tkrahn/pecanpico4/README.md

The fourth version of the Pecan Pico board and the associated software.
Some more info is on my blog: 
http://kt5tk.wordpress.com/2013/07/24/pecan-pico-4-serial-number-1-built-working
