tkrahn/pecanpico4/eagle/PecanPico4.brd

## EAGLE design eagle/PecanPico4.brd (2013-10-09)

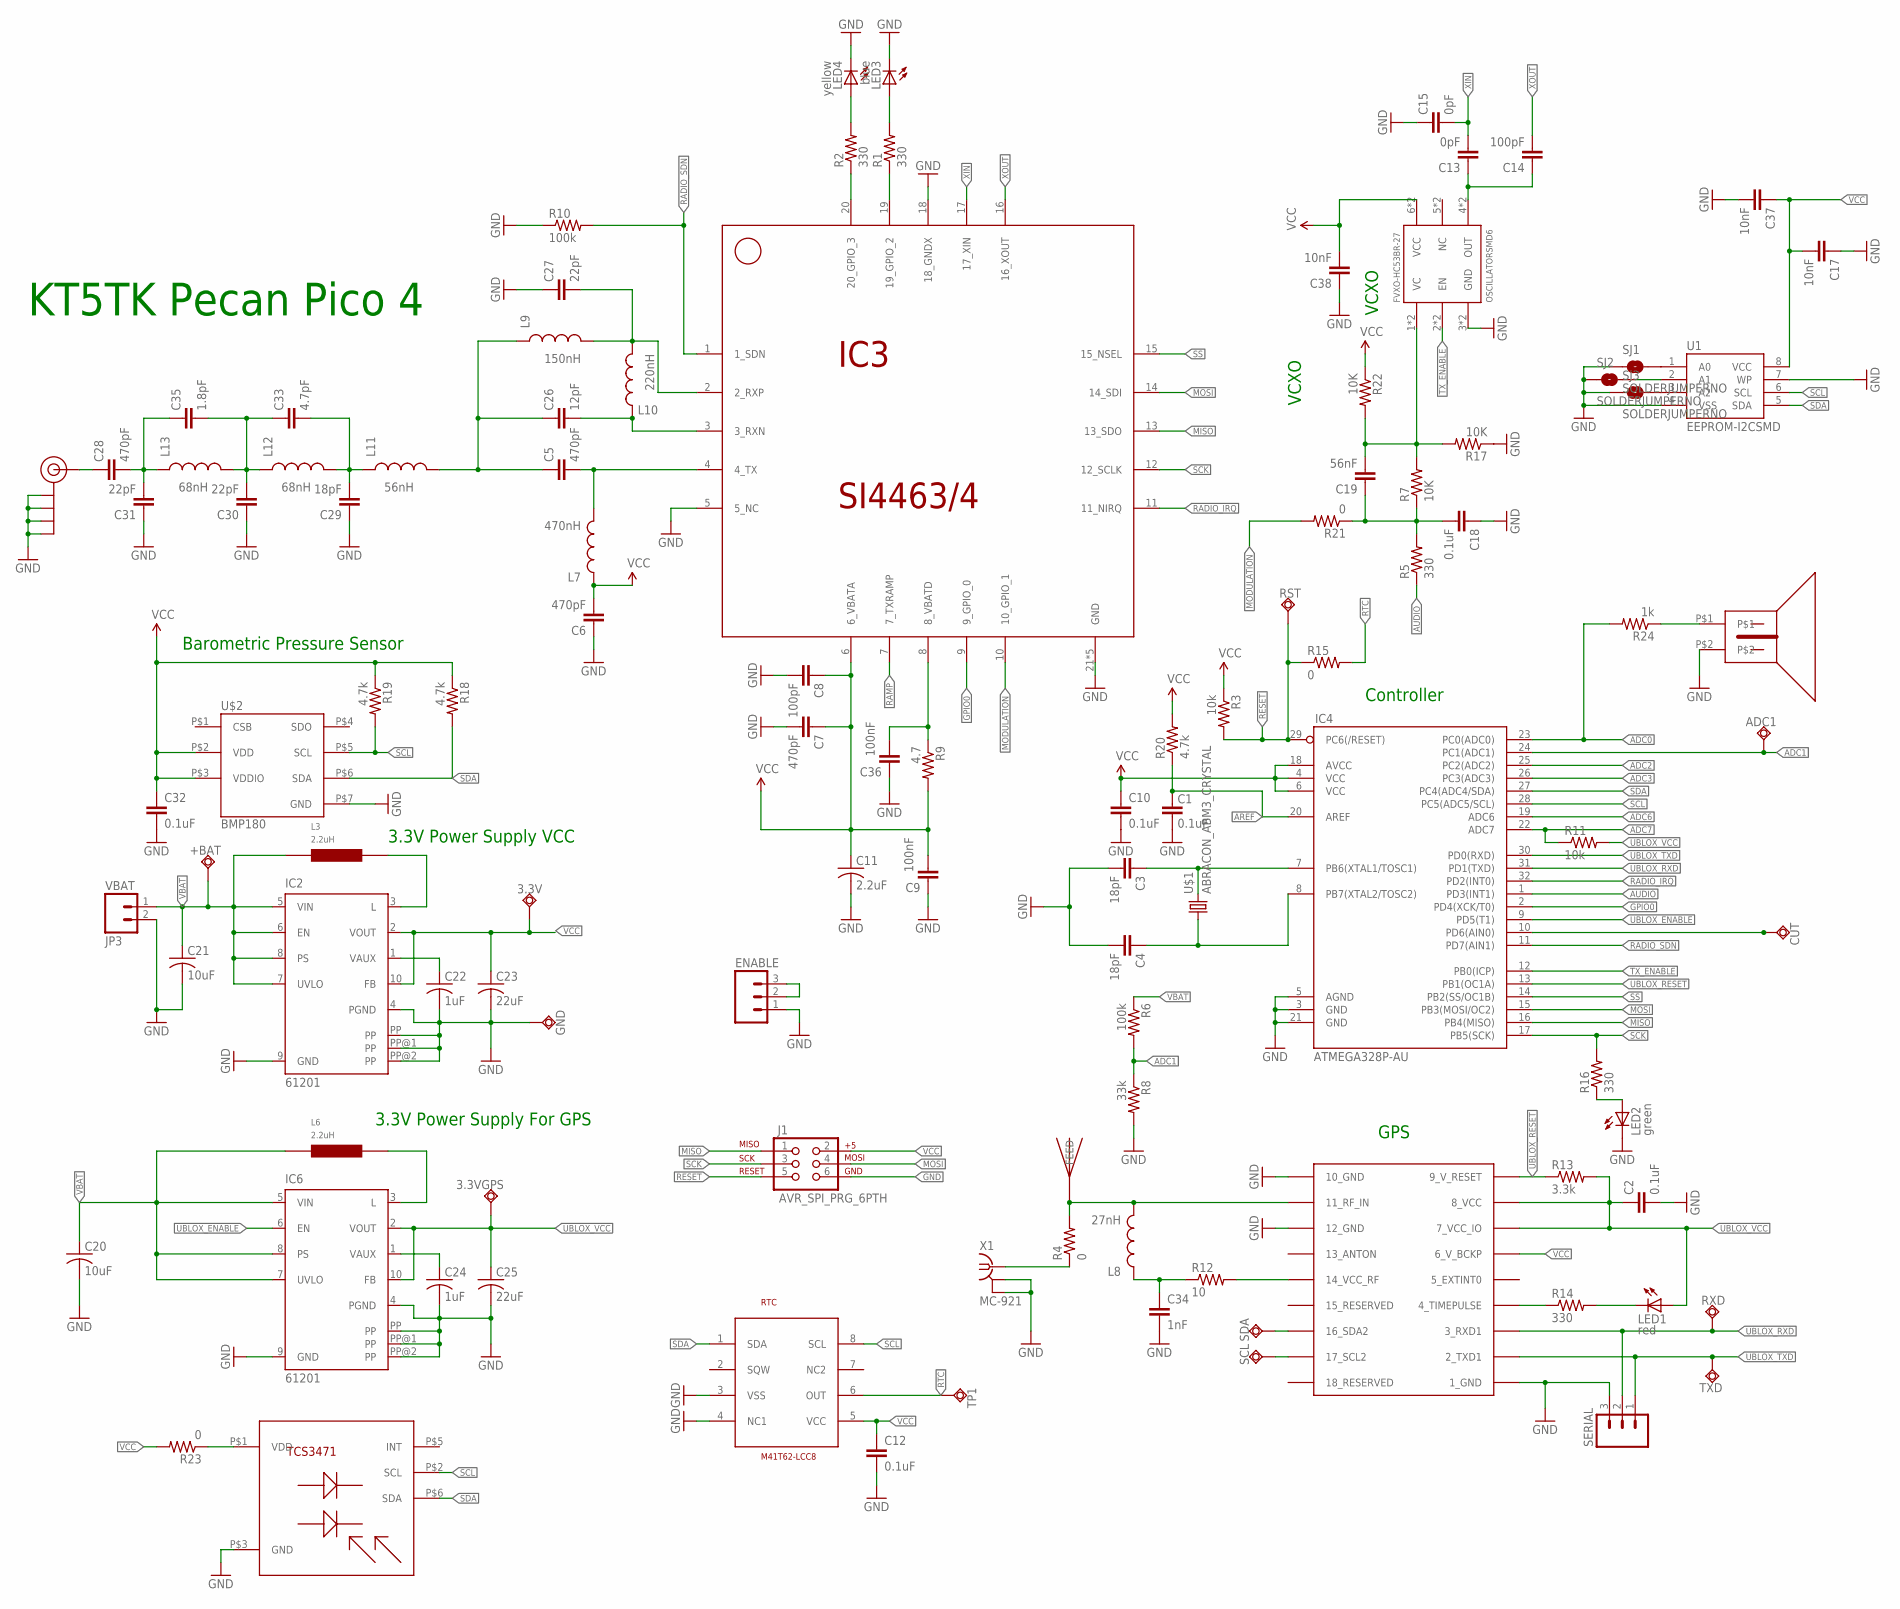
[picture p1: schematic PecanPico4.sch]

Parts:
3.3V, 3.3VGPS: TPSQTP06R; TP06R
+BAT: TPSQTP06R; TP06R
ADC1: TPSQTP06R; TP06R
C1, C2, C10, C12, C18, C32: 0.1uF; 0402-CAP
C3, C4, C29: 18pF; 0402-CAP
C5, C6, C7, C28: 470pF; 0402-CAP
C8, C14: 100pF; 0402-CAP
C9, C36: 100nF; 0402-CAP
C11: 2.2uF; C1206
C13, C15: 0pF; 0402-CAP
C17, C37, C38: 10nF; 0402-CAP
C19: 56nF; 0402-CAP
C20, C21: 10uF; C1206
C22, C24: 1uF; C1206
C23, C25: 22uF; C1206
C26: 12pF; 0402-CAP
C27, C30, C31: 22pF; 0402-CAP
C33: 4.7pF; 0402-CAP
C34: 1nF; 0402-CAP
C35: 1.8pF; 0402-CAP
CUT: TPSQTP06R; TP06R
ENABLE: M03PTH; 1X03
FVXO-HC53BR-27: OSCILLATORSMD6; CRYSTAL-SMD-7.5X5.2-6PIN
GND: TPSQTP06R; TP06R
IC2, IC6: 61201; S-PDSO-N10
IC3: SI4463/4; QFN-20
IC4: ATMEGA328P-AU; TQFP32-08
IC5: UBLOX_MAX-6
J1: AVR_SPI_PRG_6PTH; 2X3
J$2: SMA_EDGE; SMA-EDGE
JP3: VBAT; 1X02
L3, L6: 2.2uH; LPS3015
L7: 470nH; 0603
L8: 27nH; 0603
L9: 150nH; 0603
L10: 220nH; 0603
L11: 56nH; 0603
L12, L13: 68nH; 0603
LED1: red; LED-0603
LED2: green; LED-0603
LED3: blue; LED-0603
LED4: yellow; LED-0603
R1, R2, R5, R14, R16: 330; 0402-RES
R3, R11: 10k; 0402-RES
R4, R15, R21, R23: 0; 0402-RES
R6, R10: 100k; 0402-RES
R7, R17, R22: 10K; 0402-RES
R8: 33k; 0402-RES
R9: 4.7; 0402-RES
R12: 10; 0402-RES
R13: 3.3k; 0402-RES
R18, R19, R20: 4.7k; 0402-RES
R24: 1k; 0402-RES
RST: TPSQTP06R; TP06R
RTC: M41T62-LCC8; LCC-8
RXD: TPSQTP06R; TP06R
SCL: TPSQTP06R; TP06R
SDA: TPSQTP06R; TP06R
SERIAL: M03PTH; 1X03
SJ1, SJ2, SJ3: SOLDERJUMPERNO; SJ_2S-NO
SPKR: PKLCS1212E
TCS3471: TCS4371FN; TCS3471FN
TP1: TPSQTP06R; TP06R
TXD: TPSQTP06R; TP06R
U1: EEPROM-I2CSMD; SO08
U$1: ABRACON_ABM3_CRYSTAL
U$2: BMP180; LGA-7
U$3: JTI_ANTENNA-1575AT43A40
X1: MC-921

Connections:
ADC0: IC4.23 (PC0(ADC0)), R24.2
ADC1: ADC1.TP, IC4.24 (PC1(ADC1)), R6.2, R8.1
ADC2: IC4.25 (PC2(ADC2))
ADC3: IC4.26 (PC3(ADC3))
ADC6: IC4.19 (ADC6)
ADC7: IC4.22 (ADC7), R11.1
AREF: C1.2, IC4.20 (AREF), R20.1
AUDIO: IC4.1 (PD3(INT1)), R5.1
CUT: CUT.TP, IC4.10 (PD6(AIN0))
GND: C1.1, C2.2, C3.2, C4.2, C6.1, C7.2, C8.2, C9.1, C10.2, C11.2, C12.2, C15.1, C17.1, C18.1, C20.2, C21.2, C22.2, C23.2, C24.2, C25.2, C27.1, C29.1, C30.1, C31.1, C32.2, C34.2, C36.1, C37.2, C38.1, ENABLE.1, FVXO-HC53BR-27.3 (GND), FVXO-HC53BR-27.3INNER (GND), GND.TP, IC2.4 (PGND), IC2.9 (GND), IC2.PP, IC2.PP@1 (PP), IC2.PP@2 (PP), IC3.5 (5_NC), IC3.18 (18_GNDX), IC3.21 (GND), IC3.22 (GND), IC3.23 (GND), IC3.24 (GND), IC3.25 (GND), IC4.3 (GND), IC4.5 (AGND), IC4.21 (GND), IC5.1_GND, IC5.10_GND, IC5.12_GND, IC6.4 (PGND), IC6.9 (GND), IC6.PP, IC6.PP@1 (PP), IC6.PP@2 (PP), J1.6, J$2.GND@0 (GND), J$2.GND@1 (GND), J$2.GND@2 (GND), J$2.GND@3 (GND), JP3.2, LED2.C, LED3.C, LED4.C, R8.2, R10.1, R17.1, RTC.3 (VSS), RTC.4 (NC1), SERIAL.3, SJ1.1, SJ2.1, SJ3.1, SPKR.P$2, TCS3471.P$3 (GND), U1.4 (VSS), U1.7 (WP), U$2.P$7 (GND), X1.2@1 (GND), X1.2@2 (GND)
GPIO0: IC3.9 (9_GPIO_0), IC4.2 (PD4(XCK/T0))
GPSANT: IC5.11_RF_IN, L8.2, R4.2, U$3.FEED
MISO: IC3.13 (13_SDO), IC4.16 (PB4(MISO)), J1.1
MODULATION: IC3.10 (10_GPIO_1), R21.2
MOSI: IC3.14 (14_SDI), IC4.15 (PB3(MOSI/OC2)), J1.4
unnamed: R23.1, TCS3471.P$1 (VDD)
unnamed: IC5.16_SDA2, SDA.TP
unnamed: IC5.17_SCL2, SCL.TP
unnamed: IC2.3 (L), L3.P$2 (2)
unnamed: IC3.20 (20_GPIO_3), R2.1
unnamed: C18.2, C19.1, R5.2, R7.1, R21.1
unnamed: IC3.19 (19_GPIO_2), R1.1
unnamed: SJ1.2, U1.1 (A0)
unnamed: C3.1, IC4.7 (PB6(XTAL1/TOSC1)), U$1.P$2 (2)
unnamed: C4.1, IC4.8 (PB7(XTAL2/TOSC2)), U$1.P$1 (1)
unnamed: LED4.A, R2.2
unnamed: LED3.A, R1.2
unnamed: C13.1, C14.1, FVXO-HC53BR-27.4 (OUT), FVXO-HC53BR-27.4INNER (OUT)
unnamed: R4.1, X1.1
unnamed: SJ3.2, U1.3 (A2)
unnamed: SJ2.2, U1.2 (A1)
unnamed: R24.1, SPKR.P$1
unnamed: C22.1, IC2.1 (VAUX)
unnamed: IC6.3 (L), L6.P$2 (2)
unnamed: C19.2, FVXO-HC53BR-27.1 (VC), FVXO-HC53BR-27.1INNER (VC), R7.2, R17.2, R22.2
unnamed: C24.1, IC6.1 (VAUX)
unnamed: C5.2, IC3.4 (4_TX), L7.2
unnamed: C28.1, J$2.SIG (SIGNAL)
unnamed: C26.2, IC3.3 (3_RXN), L10.1
unnamed: C27.2, IC3.2 (2_RXP), L9.2, L10.2
unnamed: C5.1, C26.1, L9.1, L11.2
unnamed: C30.2, C33.1, C35.2, L12.1, L13.2
unnamed: ENABLE.2, ENABLE.3
unnamed: IC5.14_VCC_RF, R12.2
unnamed: C34.1, L8.1, R12.1
unnamed: IC5.4_TIMEPULSE, R14.1
unnamed: LED1.C, R14.2
unnamed: C29.2, C33.2, L11.1, L12.2
unnamed: C28.2, C31.2, C35.1, L13.1
unnamed: LED2.A, R16.1
unnamed: C36.2, IC3.8 (8_VBATD), R9.1
RADIO_IRQ: IC3.11 (11_NIRQ), IC4.32 (PD2(INT0))
RADIO_SDN: IC3.1 (1_SDN), IC4.11 (PD7(AIN1)), R10.2
RAMP: IC3.7 (7_TXRAMP)
RESET: IC4.29 (PC6(/RESET)), J1.5, R3.2, R15.1, RST.TP
RTC: R15.2, RTC.6 (OUT), TP1.TP
SCK: IC3.12 (12_SCLK), IC4.17 (PB5(SCK)), J1.3, R16.2
SCL: IC4.28 (PC5(ADC5/SCL)), R19.2, RTC.8 (SCL), TCS3471.P$2 (SCL), U1.6 (SCL), U$2.P$5 (SCL)
SDA: IC4.27 (PC4(ADC4/SDA)), R18.2, RTC.1 (SDA), TCS3471.P$6 (SDA), U1.5 (SDA), U$2.P$6 (SDA)
SS: IC3.15 (15_NSEL), IC4.14 (PB2(SS/OC1B))
TX_ENABLE: FVXO-HC53BR-27.2 (EN), FVXO-HC53BR-27.2INNER (EN), IC4.12 (PB0(ICP))
UBLOX_ENABLE: IC4.9 (PD5(T1)), IC6.6 (EN)
UBLOX_RESET: IC4.13 (PB1(OC1A)), IC5.9_V_RESET, R13.1
UBLOX_RXD: IC4.31 (PD1(TXD)), IC5.3_RXD1, RXD.TP, SERIAL.2
UBLOX_TXD: IC4.30 (PD0(RXD)), IC5.2_TXD1, SERIAL.1, TXD.TP
UBLOX_VCC: 3.3VGPS.TP, C2.1, C25.1, IC5.7_VCC_IO, IC5.8_VCC, IC6.2 (VOUT), IC6.10 (FB), LED1.A, R11.2, R13.2
VBAT: +BAT.TP, C20.1, C21.1, IC2.5 (VIN), IC2.6 (EN), IC2.7 (UVLO), IC2.8 (PS), IC6.5 (VIN), IC6.7 (UVLO), IC6.8 (PS), JP3.1, L3.P$1 (1), L6.P$1 (1), R6.1
VCC: 3.3V.TP, C6.2, C7.1, C8.1, C9.2, C10.1, C11.1, C12.1, C17.2, C23.1, C32.1, C37.1, C38.2, FVXO-HC53BR-27.6 (VCC), FVXO-HC53BR-27.6INNER (VCC), IC2.2 (VOUT), IC2.10 (FB), IC3.6 (6_VBATA), IC4.4 (VCC), IC4.6 (VCC), IC4.18 (AVCC), IC5.6_V_BCKP, J1.2, L7.1, R3.1, R9.2, R18.1, R19.1, R20.2, R22.1, R23.2, RTC.5 (VCC), U1.8 (VCC), U$2.P$2 (VDD), U$2.P$3 (VDDIO)
XIN: C13.2, C15.2, IC3.17 (17_XIN)
XOUT: C14.2, IC3.16 (16_XOUT)

Notes on the sheet:
KT5TK Pecan Pico 4
Barometric Pressure Sensor
Controller
3.3V Power Supply VCC
3.3V Power Supply For GPS
VCXO
GPS

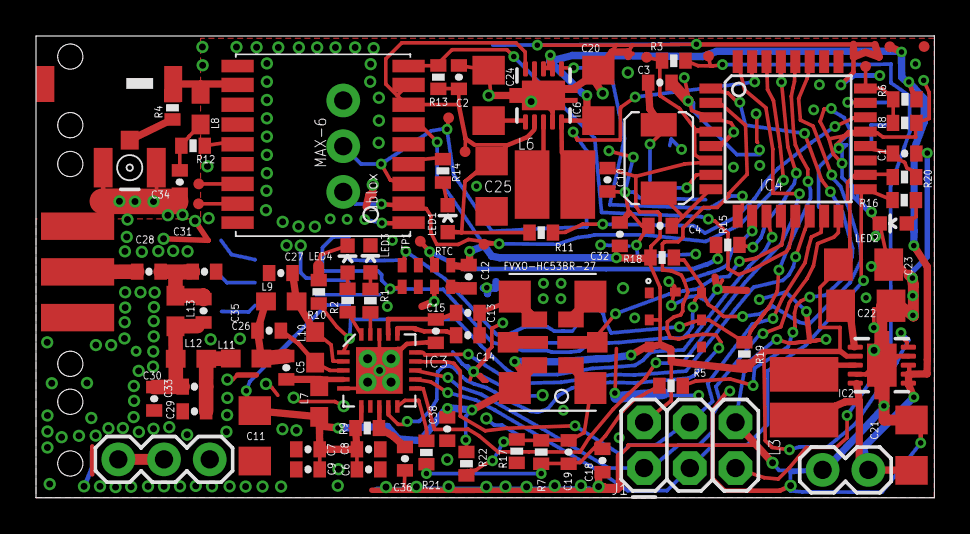
[picture p2: board PecanPico4.brd from above]

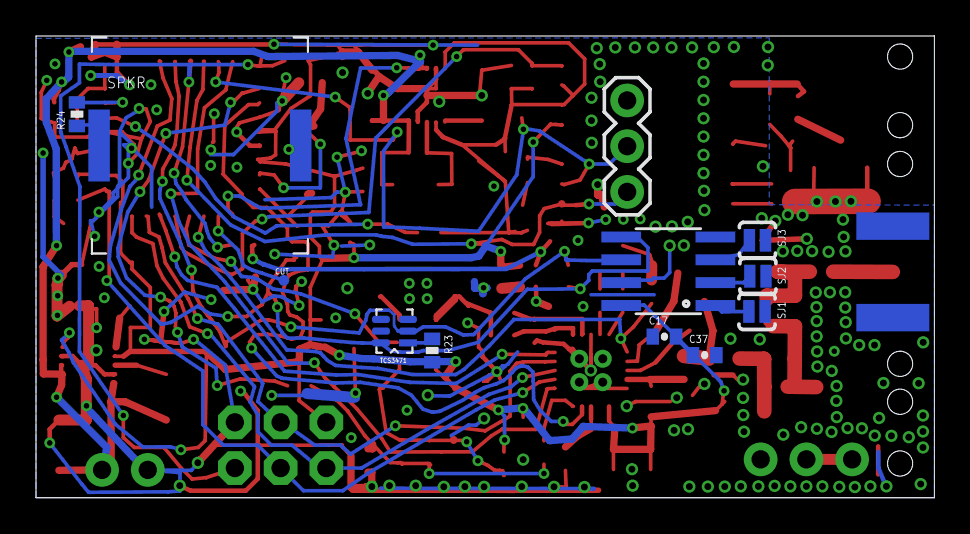
[picture p3: board PecanPico4.brd from below]

Board: 2 copper layers, 49.9 x 25.7 mm, 108 parts (12 on the bottom side), 66 nets.
