tkrahn/pecanpico4/(notices)

Notices in the files:
aprs.cpp:
modify it under the terms of the GNU General Public License
parts and their libraries:
SparkFun-FreqCtrl_TK: Licensing: CC v3.0 Share-Alike You are welcome to use this library for commercial purposes.
